mars0x1/mars0x1_LAB/bom_jlcpcb.csv

Comment | Designator | Footprint | LCSC Part #
01EC4294SHC1000UF25V | C3 C4 C1 C2 | C503217_CAP-TH_BD10_0-P5_00-D1_0-FD | C503217
35ZLH100MEFC6.3X11 | C34 C33 C35 C32 | C109392_CAP-TH_BD6_3-P2_50-D1_0-FD | C109392
C_Small | C36 C16 C8 C6 C27 C20 C21 C37 C22 C42 C19 C40 C7 C17 C43 C18 C15 C5 | C1620210_CAP-TH_L8_0-W5_0-P10_00-D0_6 | C1620210
BAT54S | D10 D9 D11 D12 | C545549_SOT-23-3_L2_9-W1_3-P1_90-LS2_4-TL | C545549
6A10 | D3 D1 D4 D2 | C2461_R-6_BD9_0-L9_0-W9_0-P15_00-D1_7-FD | C2461
BAT54S_C545549 | D6 D7 D5 D8 | C545549_SOT-23-3_L2_9-W1_3-P1_90-LS2_4-TL | C545549
CH 1 | J1 | BNC_TEConnectivity_1478035_Horizontal
PULSE 2 | J10 | BNC_TEConnectivity_1478035_Horizontal
PULSE 1 | J11 | BNC_TEConnectivity_1478035_Horizontal
AD9833 (ALT) | J12 | PinHeader_1x07_P2.54mm_Vertical
CH 2 | J2 | BNC_TEConnectivity_1478035_Horizontal
CH 3 | J3 | BNC_TEConnectivity_1478035_Horizontal
CH 4 | J4 | BNC_TEConnectivity_1478035_Horizontal
AD9833 (STD) | J5 | PinHeader_1x07_P2.54mm_Vertical
~12V AC | J6 J8 | MountingHole_2.2mm_M2_ISO7380_Pad_TopBottom
0V CT | J7 | MountingHole_2.2mm_M2_ISO7380_Pad_TopBottom
DDS OUT | J9 | BNC_TEConnectivity_1478035_Horizontal
2N3904 | Q1 Q4 | C118538_TO-92-3_L5_1-W4_1-P1_27-L | C118538
TIP31C | Q2 | C13506_TO-220-3_L10_0-W4_5-P2_54-T | C13506
TIP32C | Q3 | C75057_TO-220AB-3_L10_4-W4_6-P2_54-T | C75057
MF1/4W-200KΩ±1% T52 | R13 | C119373_RES-TH_BD2_3-L6_5-P10_50-D0_5 | C119373
MF1/4W-1KΩ±1% T52 | R2 R1 | C119353_RES-TH_BD2_3-L6_5-P10_50-D0_5 | C119353
MF1/4W-1MΩ±1%T52 | R29 | C714052_RES-TH_BD2_3-L6_5-P10_50-D0_5 | C714052
MF1/4W-20KΩ±1% T52 | R31 R23 R11 R9 R7 | C119353_RES-TH_BD2_3-L6_5-P10_50-D0_5 | C119353
1k | R32 R36 R34 R35 R33 R37 | C119353_RES-TH_BD2_3-L6_5-P10_50-D0_5 | C119353
MF1/4W-100KΩ±1% T52 | R6 R12 R22 R24 R3 R21 R10 R8 R5 | C119369_RES-TH_BD2_3-L6_5-P10_50-D0_5 | C119369
LM7812 (+12V) | U1 | C7432223_TO-220-3_L10_0-W4_6-P2_54-L | C7432223
REF3025AIDBZT | U10 | C96625_SOT-23-3_L3_0-W1_7-P0_95-LS2_9-BR | C96625
TLV9062IDR | U11 | C398355_SOIC-8_L5_0-W4_0-P1_27-LS6_0-BL | C398355
ESP32-S3-DEVKITC-1-N8R2 | U12 | XCVR_ESP32-S3-DEVKITC-1-N8R2
ENC 1 (TIME) | U17 | C2830185_SW-TH_EC11B1524XX | C2830185
ENC 2 (VOLT) | U18 | C2830185_SW-TH_EC11B1524XX | C2830185
ENC 3 (MENU) | U19 | C2830185_SW-TH_EC11B1524XX | C2830185
LM7912 (-12V) | U2 | C7432211_TO-220-3_L10_0-W4_6-P2_54-L | C7432211
LM7805 (+5V) | U5 | C725349_TO-220-3_L10_0-W4_5-P2_54-L | C725349
OPA4192IPWR | U6 | C2057935_TSSOP-14_L5_0-W4_4-P0_65-LS6_4-TL | C2057935
MCP4131-104E/P | U8 U20 | C640354_PDIP-8_L9_3-W6_4-P2_54-LS7_9-BL-1 | C640354
TL071CP | U9 | C273645_PDIP-8_L9_6-W6_4-P2_54-LS7_6-BL | C273645
