mars0x1/mars0x1_LAB/(list of files, drawings)

Other design files:
freerouting.dsn
