mars0x1/mars0x1_LAB/mars0x1_LAB.kicad_pcb

## KiCad design mars0x1_LAB.kicad_pcb (2026-11-05)

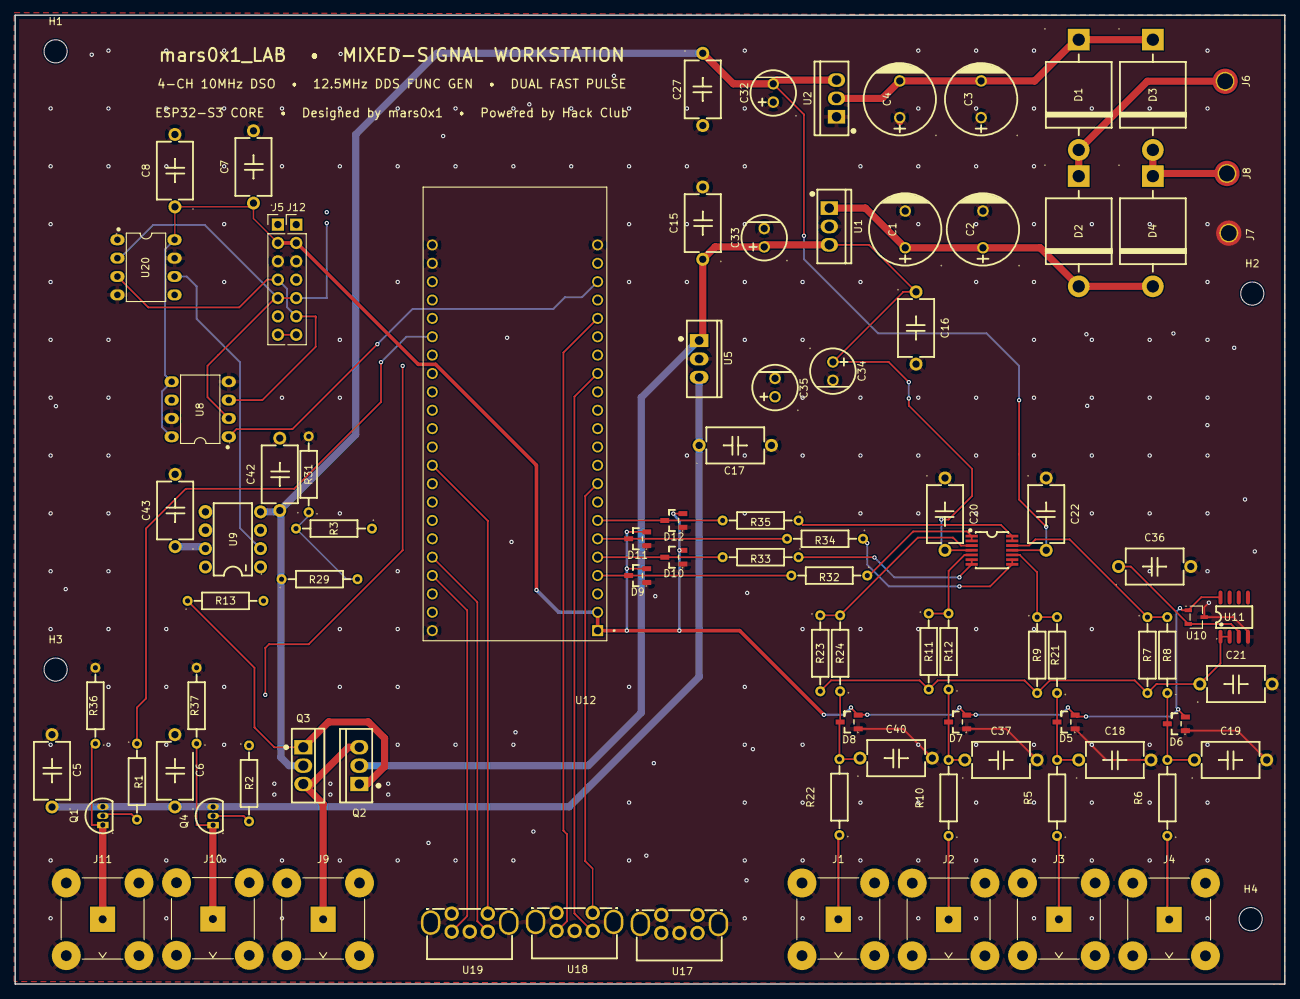
[picture p2: board mars0x1_LAB.kicad_pcb from above]

Board: 4 copper layers, 175.6 x 134.0 mm, 95 parts (0 on the bottom side), 57 nets.

Parts:
C1, C2, C3, C4: 01EC4294SHC1000UF25V; C503217_CAP-TH_BD10_0-P5_00-D1_0-FD
C5, C6, C7, C8, C15, C16, C17, C18, C19, C20, C21, C22, C27, C36, C37, C40, C42, C43: C_Small; C1620210_CAP-TH_L8_0-W5_0-P10_00-D0_6
C32, C33, C34, C35: 35ZLH100MEFC6.3X11; C109392_CAP-TH_BD6_3-P2_50-D1_0-FD
D1, D2, D3, D4: 6A10; C2461_R-6_BD9_0-L9_0-W9_0-P15_00-D1_7-FD
D5, D6, D7, D8: BAT54S_C545549; C545549_SOT-23-3_L2_9-W1_3-P1_90-LS2_4-TL
D9, D10, D11, D12: BAT54S; C545549_SOT-23-3_L2_9-W1_3-P1_90-LS2_4-TL
H1, H2, H3, H4: MountingHole_3.2mm_M3
J1: CH 1; BNC_TEConnectivity_1478035_Horizontal
J2: CH 2; BNC_TEConnectivity_1478035_Horizontal
J3: CH 3; BNC_TEConnectivity_1478035_Horizontal
J4: CH 4; BNC_TEConnectivity_1478035_Horizontal
J5: AD9833 (STD); PinHeader_1x07_P2.54mm_Vertical
J6, J8: ~12V AC; MountingHole_2.2mm_M2_ISO7380_Pad_TopBottom
J7: 0V CT; MountingHole_2.2mm_M2_ISO7380_Pad_TopBottom
J9: DDS OUT; BNC_TEConnectivity_1478035_Horizontal
J10: PULSE 2; BNC_TEConnectivity_1478035_Horizontal
J11: PULSE 1; BNC_TEConnectivity_1478035_Horizontal
J12: AD9833 (ALT); PinHeader_1x07_P2.54mm_Vertical
Q1, Q4: 2N3904; C118538_TO-92-3_L5_1-W4_1-P1_27-L
Q2: TIP31C; C13506_TO-220-3_L10_0-W4_5-P2_54-T
Q3: TIP32C; C75057_TO-220AB-3_L10_4-W4_6-P2_54-T
R1, R2: MF1/4W-1KΩ±1% T52; C119353_RES-TH_BD2_3-L6_5-P10_50-D0_5
R3, R5, R6, R8, R10, R12, R21, R22, R24: MF1/4W-100KΩ±1% T52; C119369_RES-TH_BD2_3-L6_5-P10_50-D0_5
R7, R9, R11, R23, R31: MF1/4W-20KΩ±1% T52; C119353_RES-TH_BD2_3-L6_5-P10_50-D0_5
R13: MF1/4W-200KΩ±1% T52; C119373_RES-TH_BD2_3-L6_5-P10_50-D0_5
R29: MF1/4W-1MΩ±1%T52; C714052_RES-TH_BD2_3-L6_5-P10_50-D0_5
R32, R33, R34, R35, R36, R37: 1k; C119353_RES-TH_BD2_3-L6_5-P10_50-D0_5
U1: LM7812 (+12V); C7432223_TO-220-3_L10_0-W4_6-P2_54-L
U2: LM7912 (-12V); C7432211_TO-220-3_L10_0-W4_6-P2_54-L
U5: LM7805 (+5V); C725349_TO-220-3_L10_0-W4_5-P2_54-L
U6: OPA4192IPWR; C2057935_TSSOP-14_L5_0-W4_4-P0_65-LS6_4-TL
U8, U20: MCP4131-104E/P; C640354_PDIP-8_L9_3-W6_4-P2_54-LS7_9-BL-1
U9: TL071CP; C273645_PDIP-8_L9_6-W6_4-P2_54-LS7_6-BL
U10: REF3025AIDBZT; C96625_SOT-23-3_L3_0-W1_7-P0_95-LS2_9-BR
U11: TLV9062IDR; C398355_SOIC-8_L5_0-W4_0-P1_27-LS6_0-BL
U12: ESP32-S3-DEVKITC-1-N8R2; XCVR_ESP32-S3-DEVKITC-1-N8R2
U17: ENC 1 (TIME); C2830185_SW-TH_EC11B1524XX
U18: ENC 2 (VOLT); C2830185_SW-TH_EC11B1524XX
U19: ENC 3 (MENU); C2830185_SW-TH_EC11B1524XX

Connections:
2.5V: C21.1, R7.2, R9.2, R11.2, R23.2, U11.1 (OUTA), U11.2 (INA-)
3.3V: C7.1, C8.1, D5.2 (A), D6.2 (A), D7.2 (A), D8.2 (A), D9.2 (A), D10.2 (A), D11.2 (A), D12.2 (A), J5.2, J12.2, U8.5 (P0A), U8.8 (VDD), U10.1 (IN), U11.8 (VCC), U12.J1_1 (3V3), U12.J1_2 (3V3), U20.8 (VDD)
+5V: C5.1, C6.1, C17.1, C35.1, Q1.3 (C), Q4.3 (C), U5.3 (OUTPUT)
+12: C15.1, C16.1, C20.2, C33.1, C34.1, C43.1, Q2.2 (C), U1.3 (VOUT), U5.1 (INPUT), U6.4 (V+), U9.7 (VCC+)
+12AC: D3.2 (K), D4.1 (A), J8.1
-12AC: D1.2 (K), D2.1 (A), J6.1
-12V: C22.2, C27.1, C32.2, C42.1, Q3.2 (C), R29.1, U2.3 (OUT), U6.11 (V-), U9.4 (VCC-)
Amplitude: R13.2, U9.2 (IN-), U20.6 (P0W)
CH1_BUF: R32.1, U6.1 (OUTA), U6.2 (-INA)
CH2_BUF: R33.1, U6.6 (-INB), U6.7 (OUTB)
CH3_BUF: R34.1, U6.8 (OUTC), U6.9 (-INC)
CH4_BUF: R35.1, U6.13 (-IND), U6.14 (OUTD)
CH-1: D9.3 (2), R32.2, U12.J1_4 (GPIO4)
CH-2: D10.3 (2), R33.2, U12.J1_5 (GPIO5)
CH-3: D11.3 (2), R34.2, U12.J1_6 (GPIO6)
CH-4: D12.3 (2), R35.2, U12.J1_7 (GPIO7)
DGND: C1.2, C2.2, C3.1, C4.1, C5.2, C6.2, C7.2, C8.2, C15.2, C16.2, C17.2, C18.2, C19.2, C20.1, C21.2, C22.1, C27.2, C32.1, C33.2, C34.2, C35.2, C36.2, C37.2, C40.2, C42.2, C43.2, D5.1 (A), D6.1 (A), D7.1 (A), D8.1 (A), D9.1 (A), D10.1 (A), D11.1 (A), D12.1 (A), J1.2, J2.2, J3.2, J4.2, J5.3, J7.1, J9.2, J10.2, J11.2, J12.3, R31.2, R36.2, R37.2, U1.2 (GND), U2.1 (GND), U5.2 (GND), U8.4 (VSS), U8.7 (P0B), U10.3 (GND), U11.4 (VEE/GND), U12.J1_22 (GND), U12.J3_1 (GND), U12.J3_21 (GND), U12.J3_22 (GND), U17.C, U17.D, U17.EH, U18.C, U18.D, U18.EH, U19.C, U19.D, U19.EH, U20.4 (VSS), U20.7 (P0B)
GPIO 1: U12.J3_4 (GPIO1), U19.A
GPIO 2: U12.J3_5 (GPIO2), U19.B
GPIO 8: U12.J1_12 (GPIO8), U17.E
GPIO 9: U12.J1_15 (GPIO9), U18.B
GPIO 10: J5.6, J12.4, U12.J1_16 (GPIO10)
GPIO 11: J5.4, J12.6, U8.3 (SDI/SDO), U12.J1_17 (GPIO11), U20.3 (SDI/SDO)
GPIO 12: U12.J1_18 (GPIO12), U18.A
GPIO 13: J5.5, J12.5, U8.2 (SCK), U12.J1_19 (GPIO13), U20.2 (SCK)
GPIO 14: U8.1 (CS#), U12.J1_20 (GPIO14)
GPIO 15: U12.J1_8 (GPIO15), U20.1 (CS#)
GPIO 16: U12.J1_9 (GPIO16), U18.E
GPIO 17: U12.J1_10 (GPIO17), U17.A
GPIO 18: U12.J1_11 (GPIO18), U17.B
GPIO 21: R2.1, U12.J3_18 (GPIO21)
GPIO 38: U12.J3_10 (GPIO38), U19.E
GPIO 47: R1.1, U12.J3_17 (GPIO47)
INA+: R23.1, R24.2, U6.3 (+INA)
INB+: R11.1, R12.2, U6.5 (+INB)
INC+: R9.1, R21.2, U6.10 (+INC)
IND+: R7.1, R8.2, U6.12 (+IND)
unnamed: C3.2, C4.2, D1.1 (A), D3.1 (A), U2.2 (IN)
unnamed: C1.1, C2.1, D2.2 (K), D4.2 (K), U1.1 (VCC)
unnamed: C18.1, D5.3 (2), R5.2, R21.1
unnamed: C19.1, D6.3 (2), R6.2, R8.1
unnamed: C37.1, D7.3 (2), R10.2, R12.1
unnamed: C40.1, D8.3 (2), R22.2, R24.1
unnamed: J3.1, R5.1
unnamed: J4.1, R6.1
unnamed: J2.1, R10.1
unnamed: J1.1, R22.1
unnamed: J5.7, J12.7, U20.5 (P0A)
unnamed: Q1.2 (B), R1.2
unnamed: J11.1, Q1.1 (E), R36.1
unnamed: Q2.1 (B), Q3.1 (B), R13.1, U9.6 (OUT)
unnamed: J9.1, Q2.3 (E), Q3.3 (E)
unnamed: Q4.2 (B), R2.2
unnamed: J10.1, Q4.1 (E), R37.1
unnamed: R3.1, U8.6 (P0W)
unnamed: R3.2, R29.2, R31.1, U9.3 (IN+)
ref: C36.1, U10.2 (OUT), U11.3 (INA+)
