mars0x1/mars0x1_LAB/(commit log)

2026-11-04 Align EC11 rotary encoder 3D model offset (11mm, -11.5mm) and refresh renders
2026-11-05 Fix BNC symbol shield pins (S1-S4 -> 2) and sync footprint UUID paths to eliminate Update PCB duplicates
2026-11-05 Update production Gerbers archive with synchronized BNC footprints
2026-11-07 Add JLCPCB assembly BOM/CPL and LCSC BOM spreadsheets
